MaximeHTL/piazzetta-433-esphome/(commit log)

2026-10-23 Docs: wiring diagram, sharper remote photo, references to the parts
2026-10-23 HA package: heater switch keeps its state during module outages (min cycle no longer reset)
2026-10-25 Component: on/off debounce and periodic screen resync; HA switch ignores unknown states
    - On/off requests are ignored for 90 s after a long press: the state lags a
    few seconds behind, and three toggles in 47 s once stopped then re-ignited
    the stove
    - Fan-key resynchronisation repeated when no main screen was seen for 5 min
    (transition), 30 min (running/off) or 45 s after an on/off: one missed
    frame left Home Assistant stuck on an outdated phase
    - Heater switch keeps its last state when the stove state is "Autre"
    (corrupted frame, clock menu), so the thermostat cycle is not restarted
    - Docs: USB cable pitfall (about 20 dB of 433 MHz reception lost), lessons learned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
    [piazzetta.cpp, piazzetta.h]
2026-10-25 Component: reject frames with a wrong parity or stop bit
    The 8-bit checksum let two corrupted screens through on the same day (a
    mangled phase with 9 °C, an unreadable line with 186 °C). Frames are now
    rejected when one of their useful bytes (32 for a screen, 6 for the clock,
    5 for a remote frame) has a wrong parity or stop bit. Replayed on 895
    archived frames with a good checksum: none rejected.
    [piazzetta.cpp]
2026-10-28 Reliability update: toggle lock, stray-bit repair, restart-proof 1 h guard
    Component:
    - Toggle lock until confirmation: after an on/off long press, no new
    toggle until a main screen shows a different known state (max 20 min);
    screen re-read every 2 min meanwhile.
    - Repair of a single stray bit (one byte with a wrong parity whose extra
    bit matches the checksum difference); other defects still rejected.
    - Iterative glitch merge at 0.45 bit (DIO2 output moves in 64 us steps).
    - RSSI read only while the carrier is on (SPI reads during silences
    created glitches on DIO2).
    - New diagnostic entities: bascule_en_attente, age_ecran,
    trames_rejetees, trames_corrigees.
    ESPHome example: api.re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
    [piazzetta.cpp, piazzetta.h]
2026-10-28 Docs: generic thermostat thresholds are strict (20.4 / 21.6 with a 0.1 C sensor)
